alecelular/nanoosciloscopio/Fotos/Arduino_NANO_128x32/IMG_20260410_170420.jpg

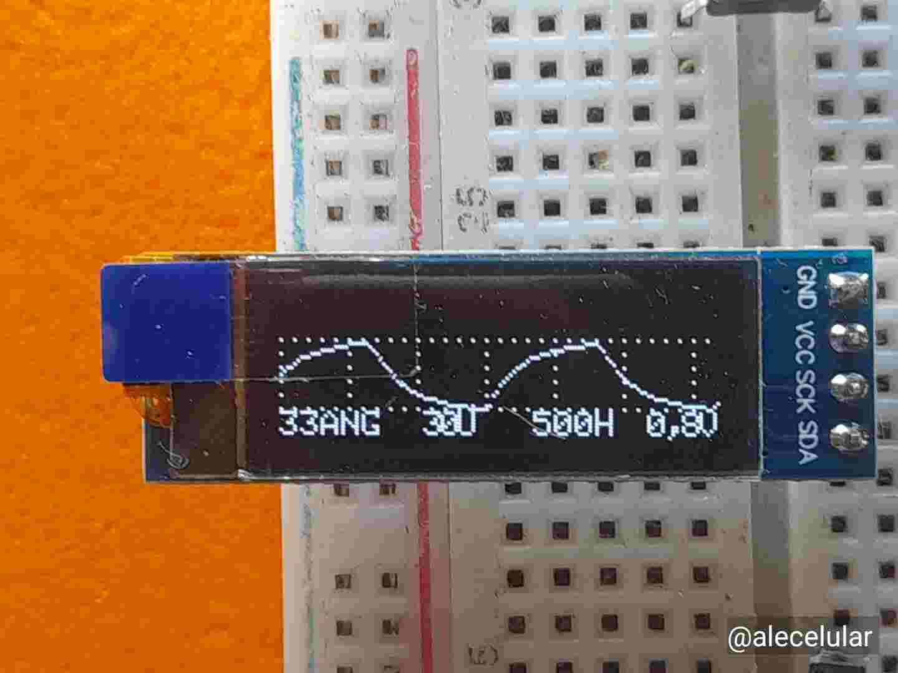
Fotos/Arduino_NANO_128x32/IMG_20260410_170420.jpg
