alecelular/nanoosciloscopio/Fotos/Arduino_PRO_Mini/IMG_20260922_135904.jpg

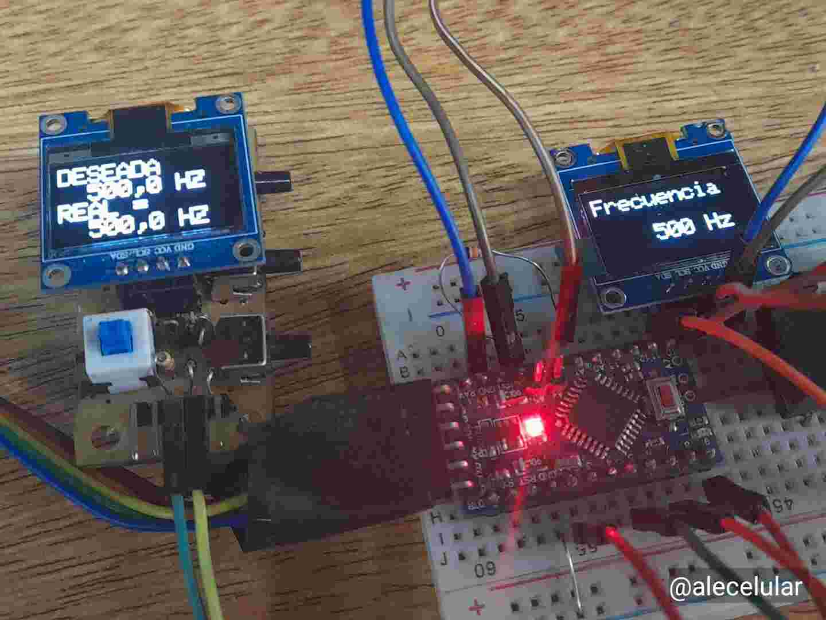
Fotos/Arduino_PRO_Mini/IMG_20260922_135904.jpg
