alecelular/nanoosciloscopio/Fotos/Arduino_PRO_Mini/IMG_20260922_142356.jpg

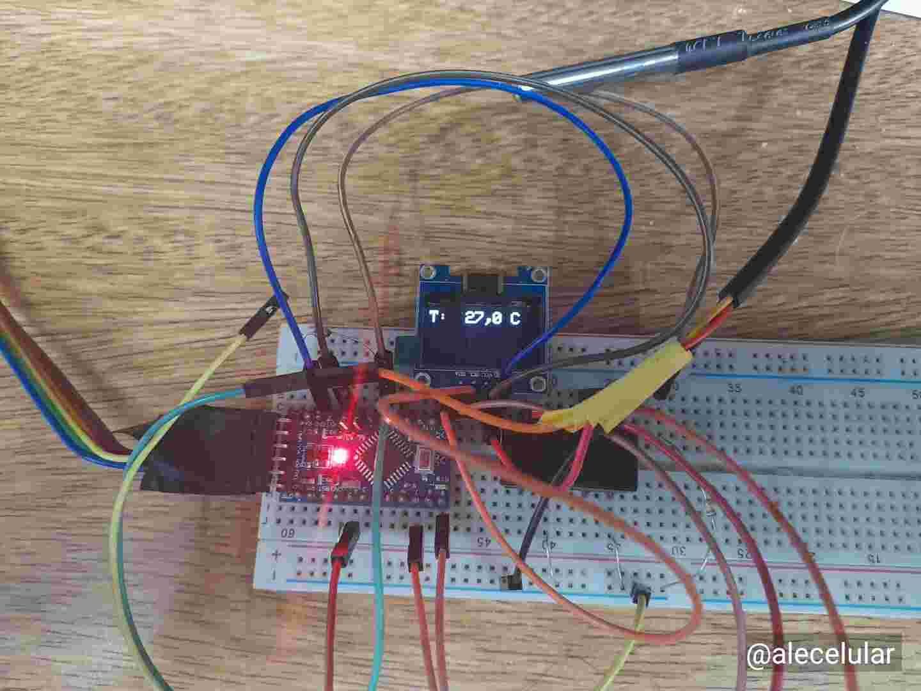
Fotos/Arduino_PRO_Mini/IMG_20260922_142356.jpg
