alecelular/nanoosciloscopio/Fotos/Arduino_PRO_Mini/IMG_20260926_133228.jpg

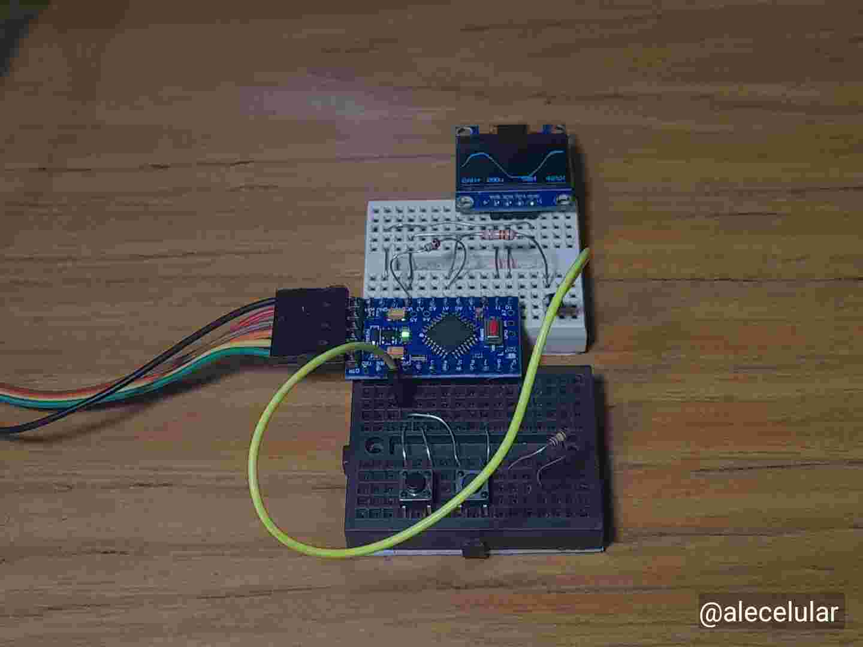
Fotos/Arduino_PRO_Mini/IMG_20260926_133228.jpg
