alecelular/nanoosciloscopio/Fotos/Arduino_PRO_Mini/IMG_20260927_163220.jpg

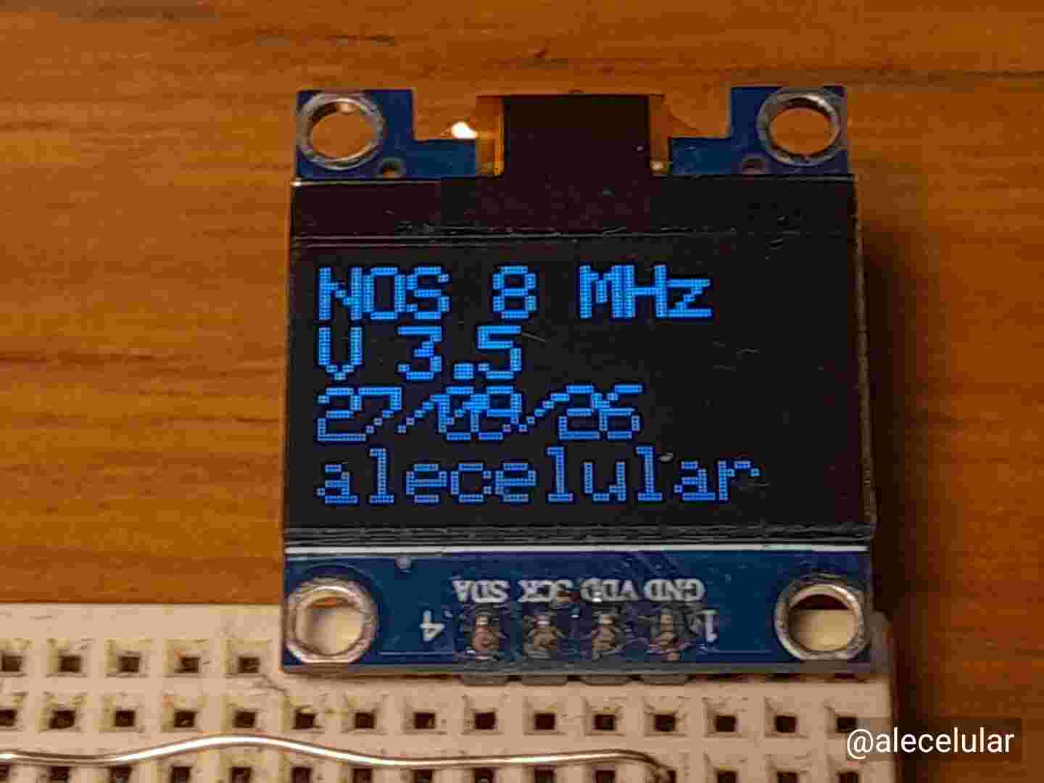
Fotos/Arduino_PRO_Mini/IMG_20260927_163220.jpg
