alecelular/nanoosciloscopio/Fotos/Arduino_PRO_Mini/IMG_20260927_163222.jpg

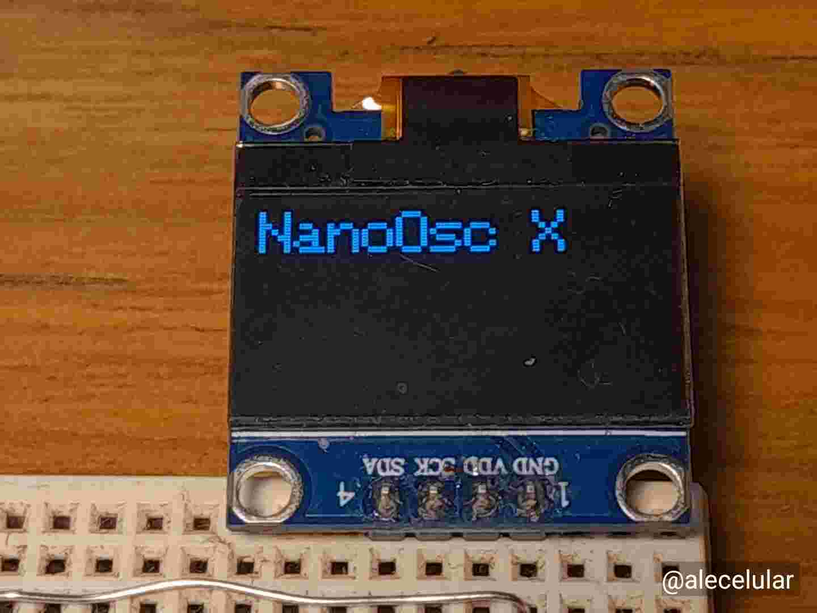
Fotos/Arduino_PRO_Mini/IMG_20260927_163222.jpg
