alecelular/nanoosciloscopio/Fotos/ATtiny85/IMG_20260514_092656.jpg

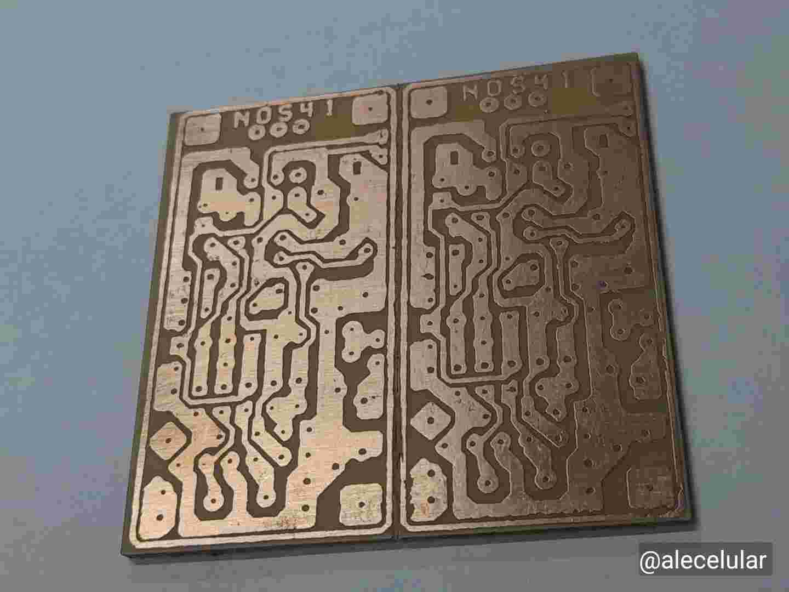
Fotos/ATtiny85/IMG_20260514_092656.jpg
