alecelular/nanoosciloscopio/Fotos/ATtiny85/IMG_20260514_103825.jpg

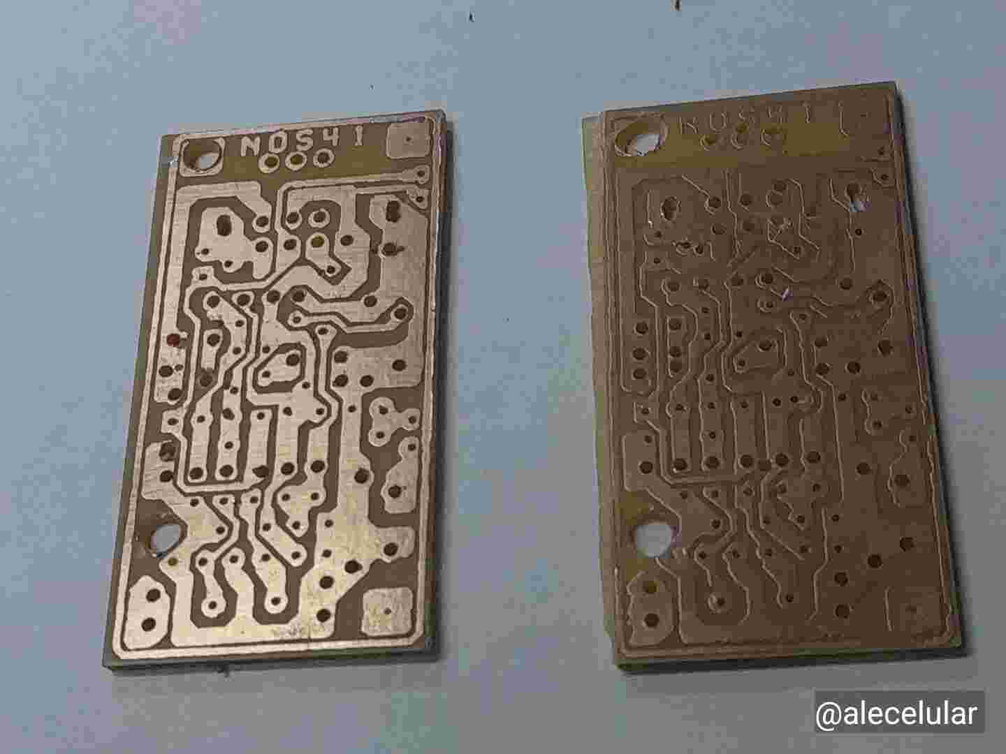
Fotos/ATtiny85/IMG_20260514_103825.jpg
