alecelular/nanoosciloscopio/Fotos/ATtiny85/IMG_20260515_105952.jpg

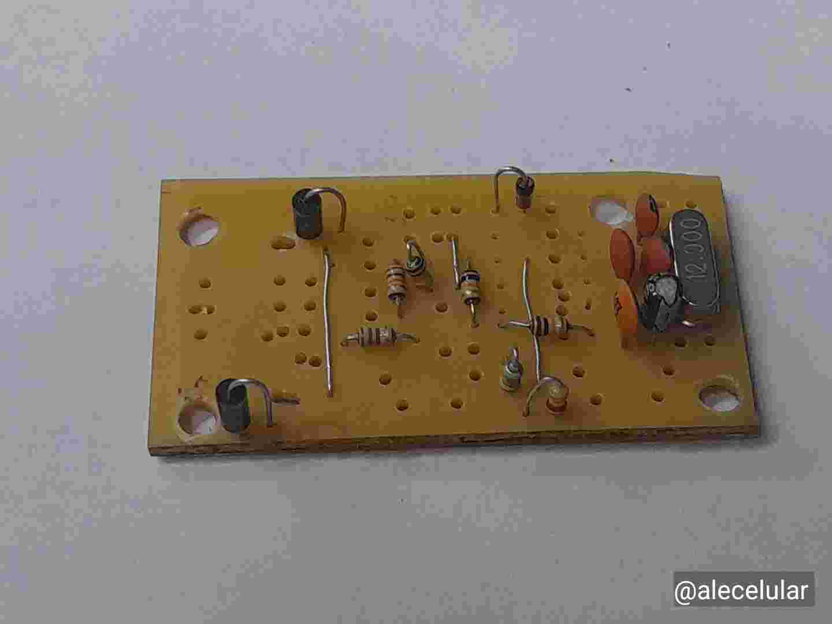
Fotos/ATtiny85/IMG_20260515_105952.jpg
