alecelular/nanoosciloscopio/Fotos/ATtiny85/IMG_20260515_112648.jpg

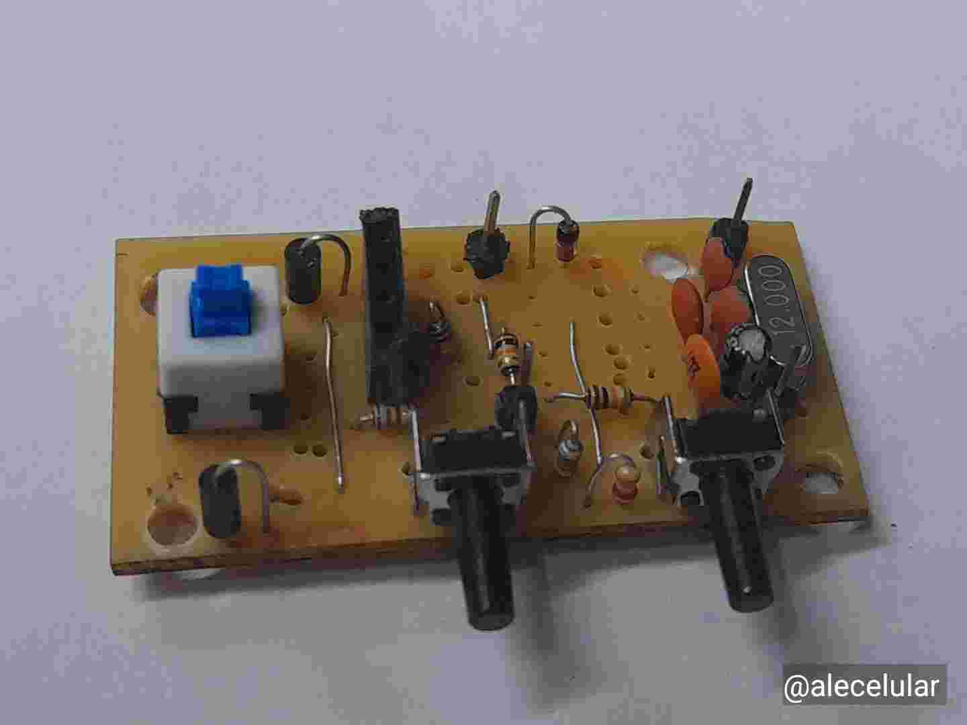
Fotos/ATtiny85/IMG_20260515_112648.jpg
