alecelular/nanoosciloscopio/Fotos/ATtiny85/IMG_20260515_112658.jpg

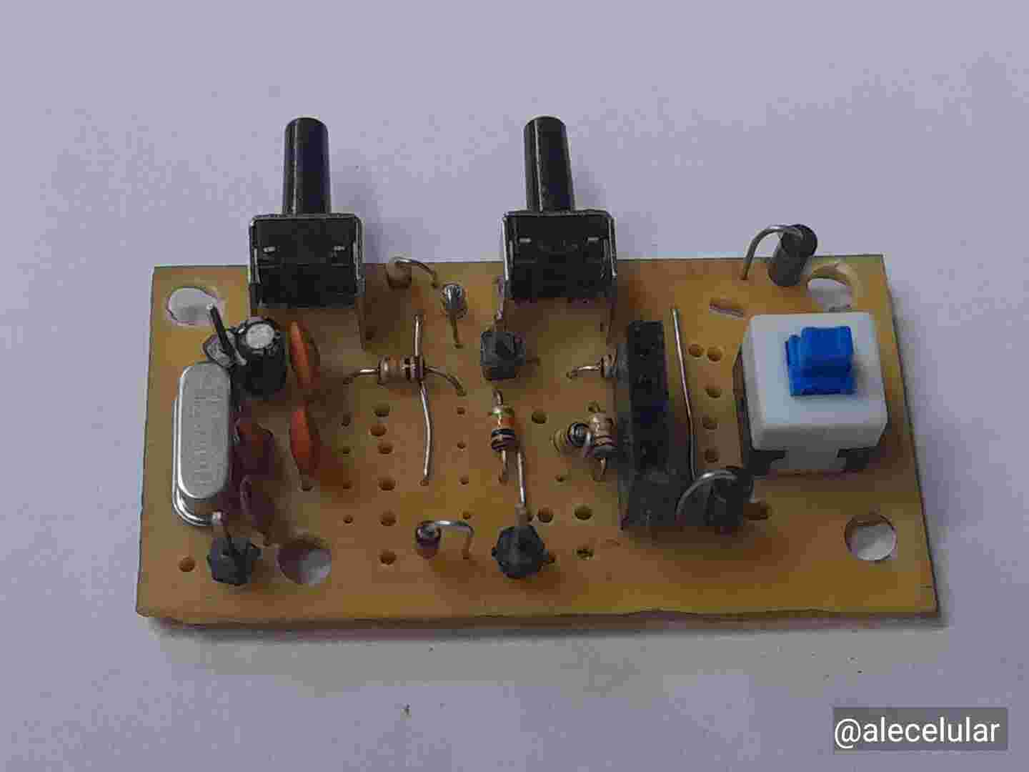
Fotos/ATtiny85/IMG_20260515_112658.jpg
