alecelular/nanoosciloscopio/Fotos/ATtiny85/IMG_20260515_113447.jpg

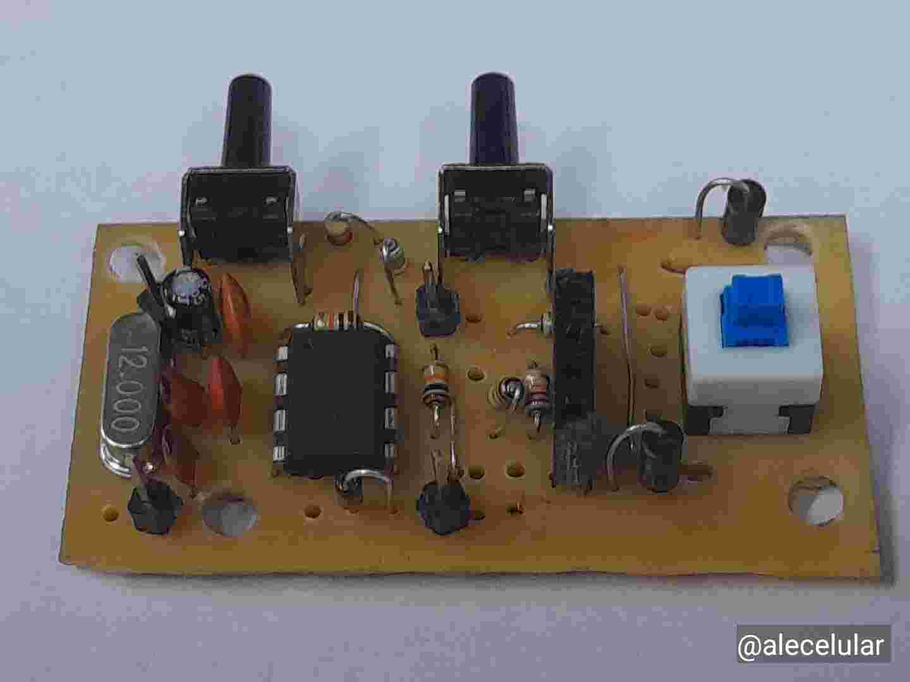
Fotos/ATtiny85/IMG_20260515_113447.jpg
