alecelular/nanoosciloscopio/Fotos/ATtiny85/IMG_20260515_121459.jpg

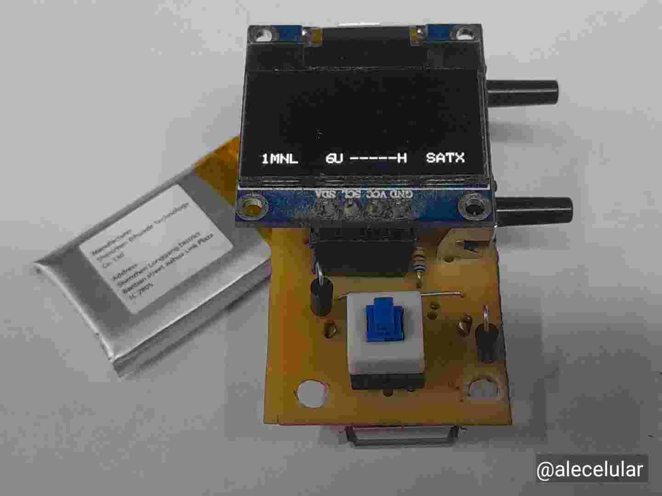
Fotos/ATtiny85/IMG_20260515_121459.jpg
