alecelular/nanoosciloscopio/Fotos/ATtiny85/IMG_20260515_121541.jpg

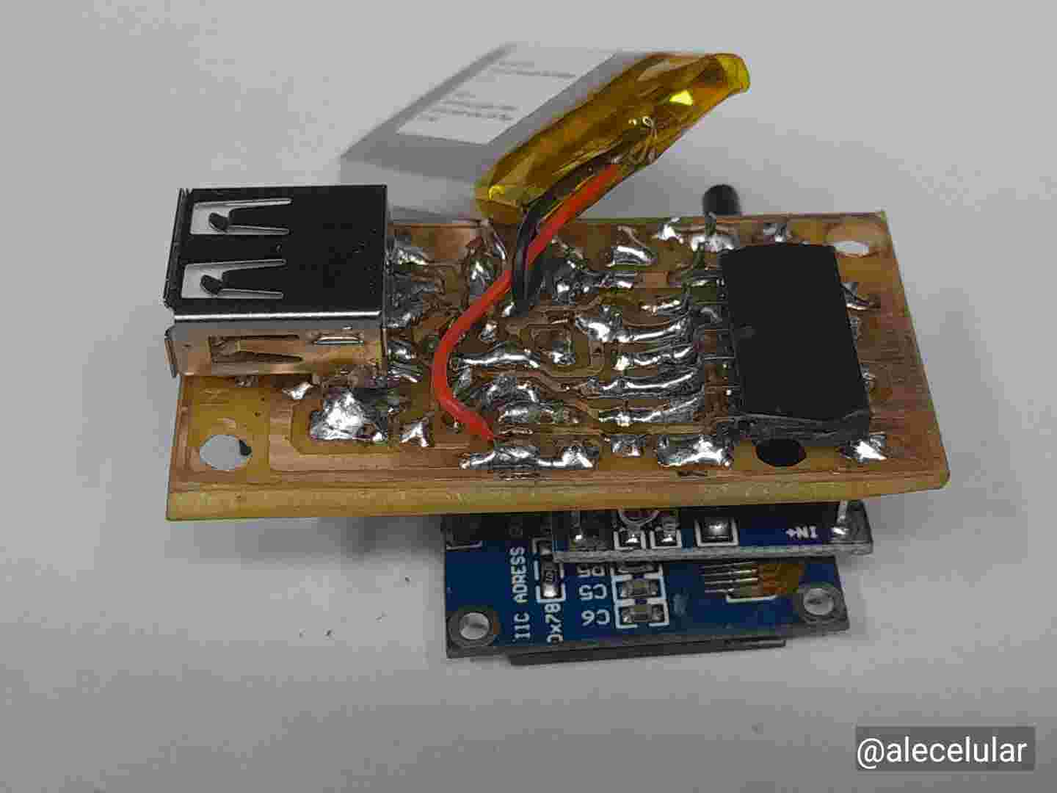
Fotos/ATtiny85/IMG_20260515_121541.jpg
