alecelular/nanoosciloscopio/Fotos/ATtiny85/IMG_20260515_134651.jpg

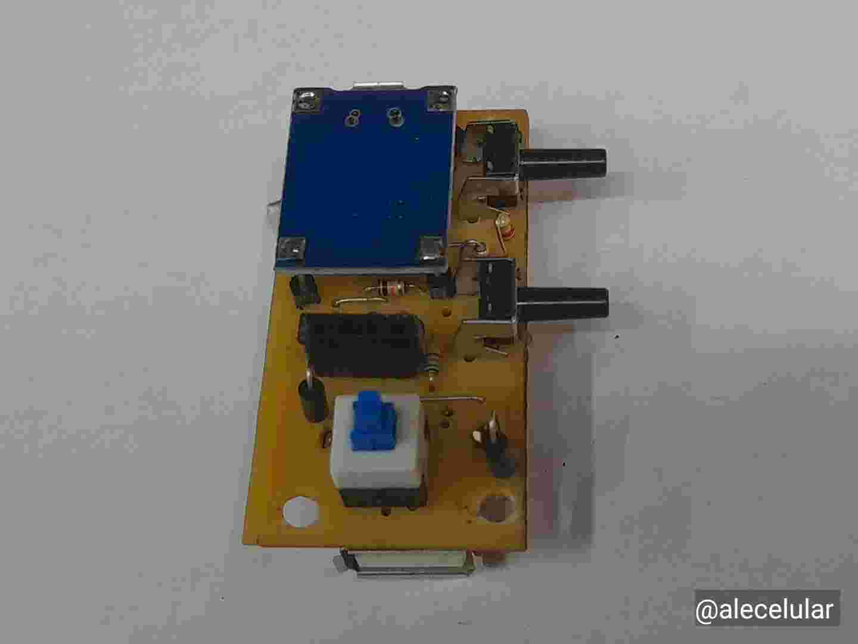
Fotos/ATtiny85/IMG_20260515_134651.jpg
