alecelular/nanoosciloscopio/Fotos/ATtiny85/IMG_20260527_100653.jpg

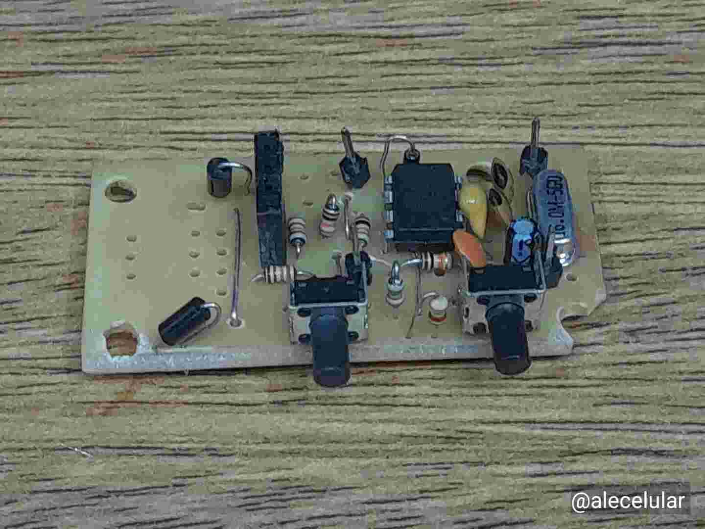
Fotos/ATtiny85/IMG_20260527_100653.jpg
