alecelular/nanoosciloscopio/Fotos/ATtiny85/IMG_20260527_103941.jpg

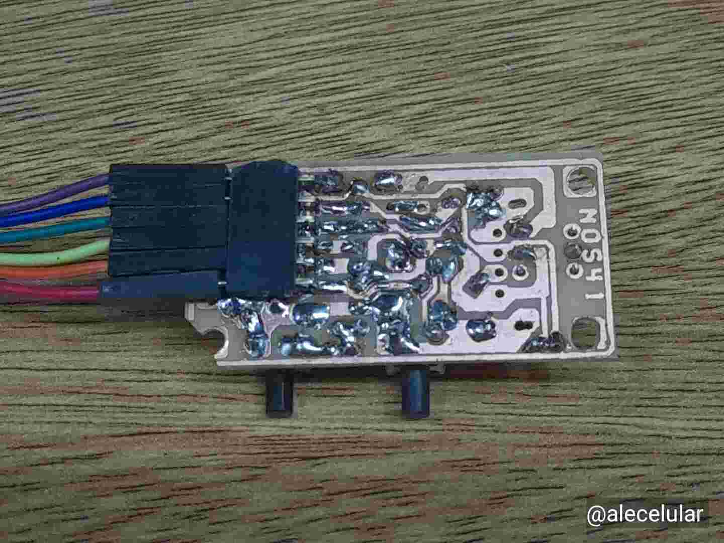
Fotos/ATtiny85/IMG_20260527_103941.jpg
