alecelular/nanoosciloscopio/Fotos/ATtiny85/IMG_20260527_104001.jpg

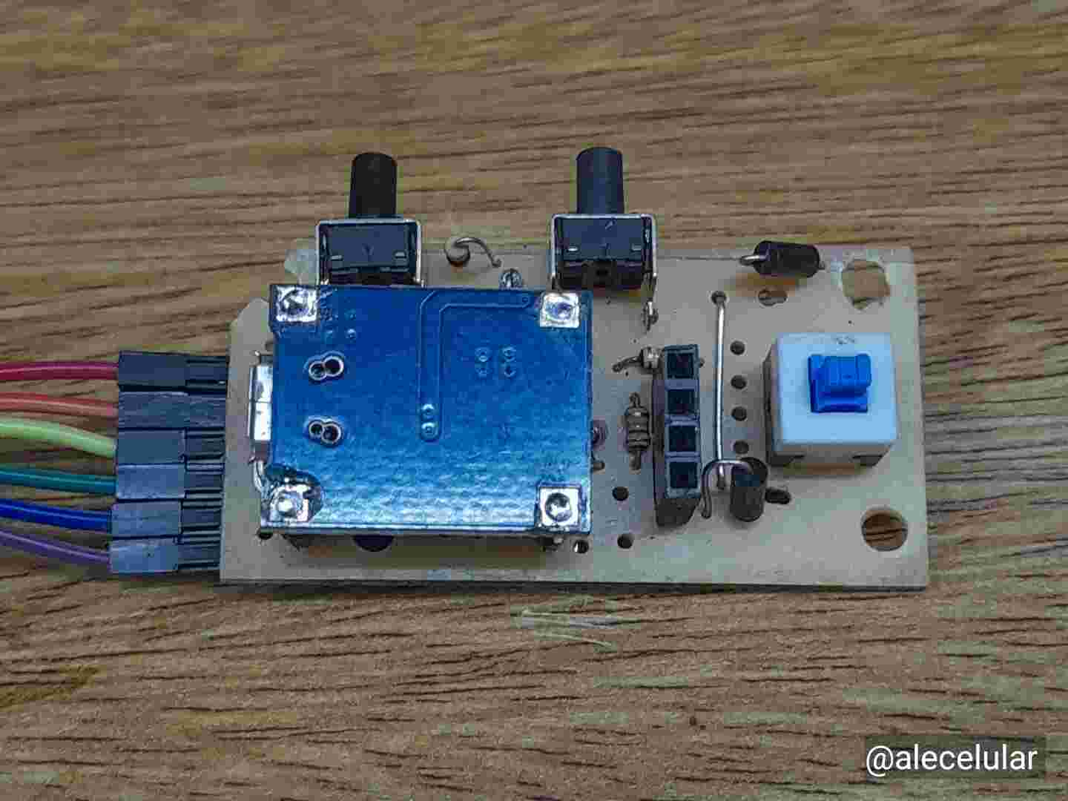
Fotos/ATtiny85/IMG_20260527_104001.jpg
