alecelular/nanoosciloscopio/Fotos/ATtiny85/IMG_20260527_104021.jpg

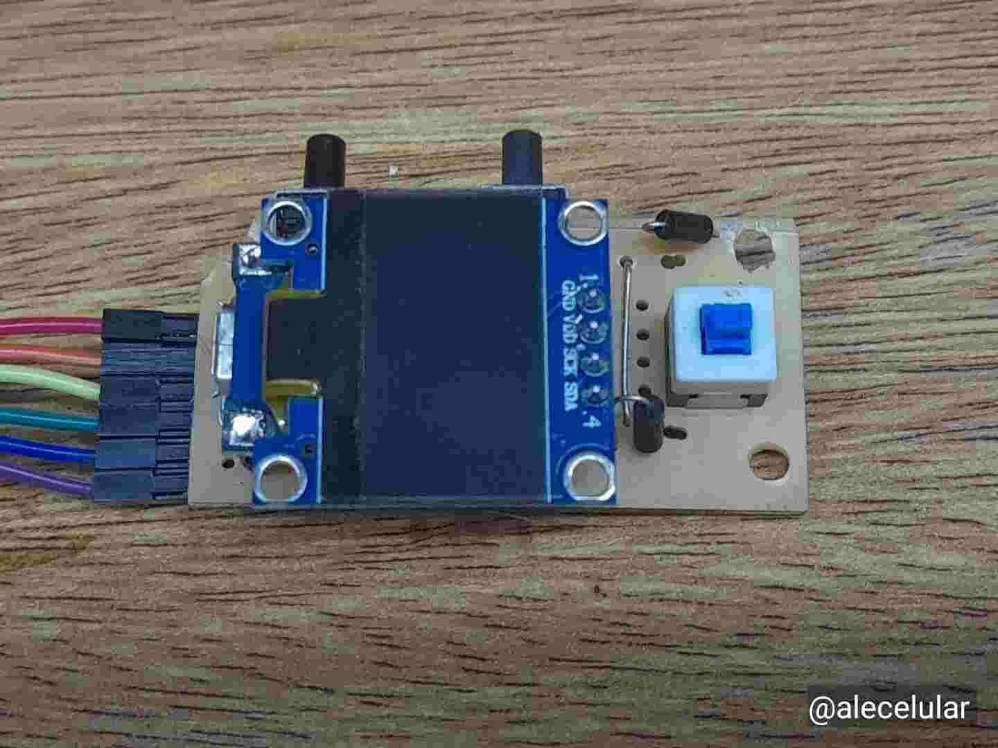
Fotos/ATtiny85/IMG_20260527_104021.jpg
