alecelular/nanoosciloscopio/Fotos/ATtiny85/IMG_20260527_130948.jpg

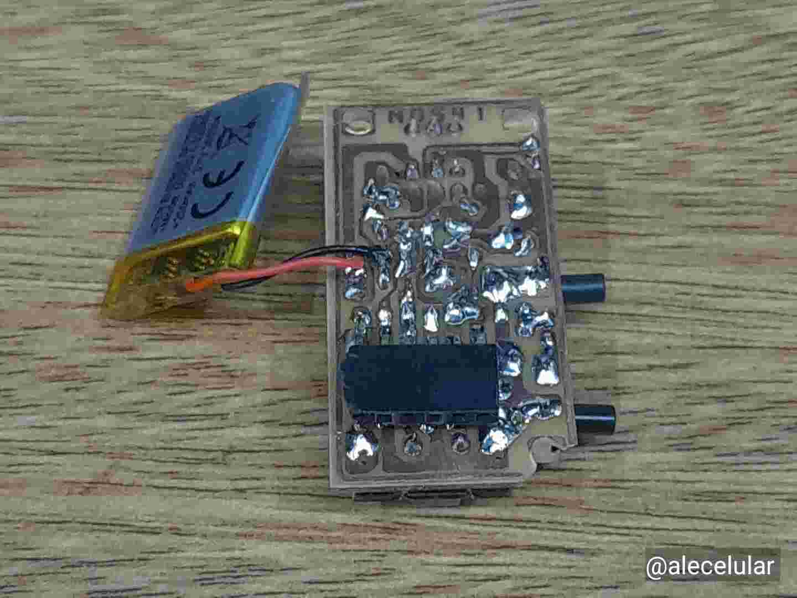
Fotos/ATtiny85/IMG_20260527_130948.jpg
