alecelular/nanoosciloscopio/Fotos/ATtiny85/IMG_20260527_131004.jpg

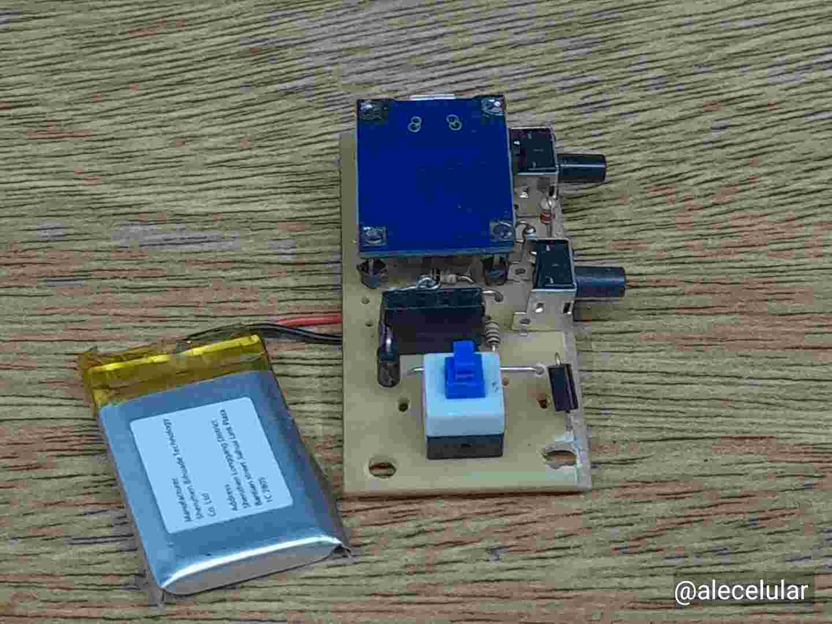
Fotos/ATtiny85/IMG_20260527_131004.jpg
