alecelular/nanoosciloscopio/Fotos/ATtiny85/IMG_20260527_131022.jpg

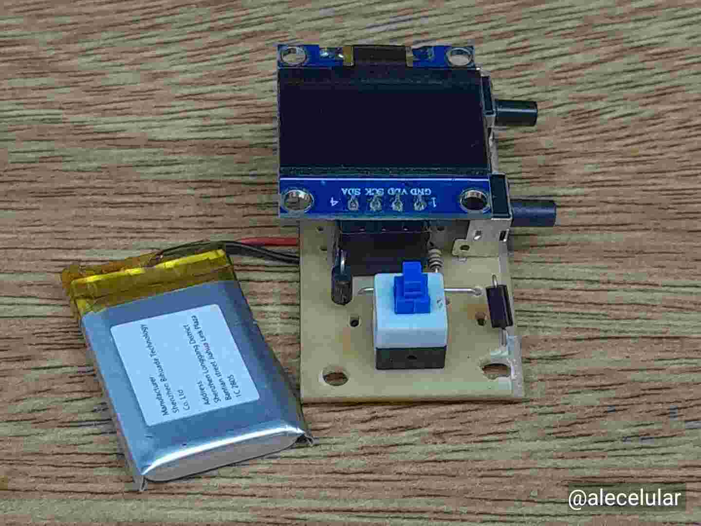
Fotos/ATtiny85/IMG_20260527_131022.jpg
