alecelular/nanoosciloscopio/Fotos/ATtiny85/IMG_20260527_200803.jpg

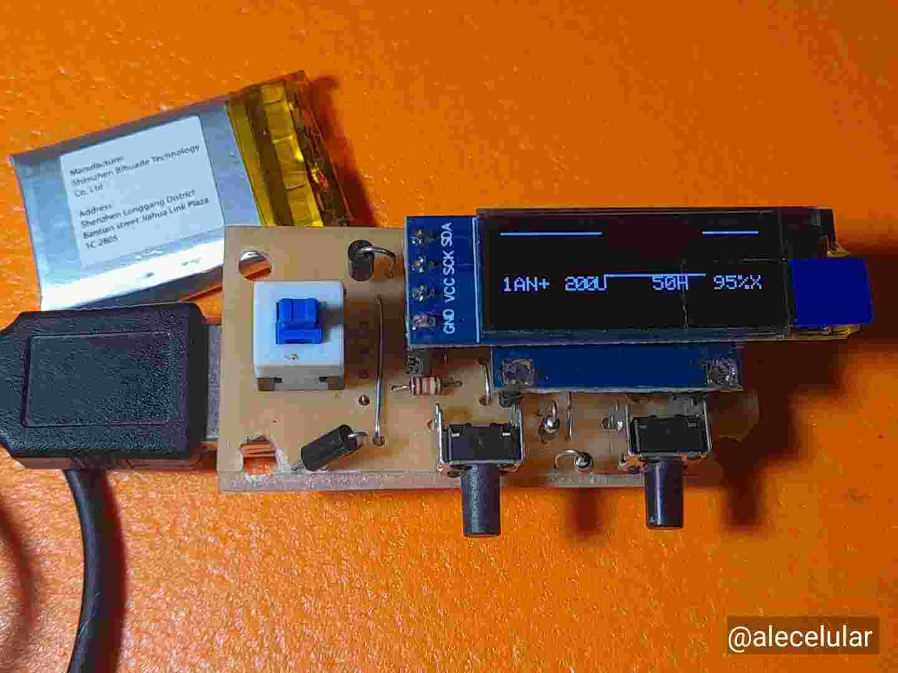
Fotos/ATtiny85/IMG_20260527_200803.jpg
