alecelular/nanoosciloscopio/Fotos/ATtiny85/IMG_20260529_213239.jpg

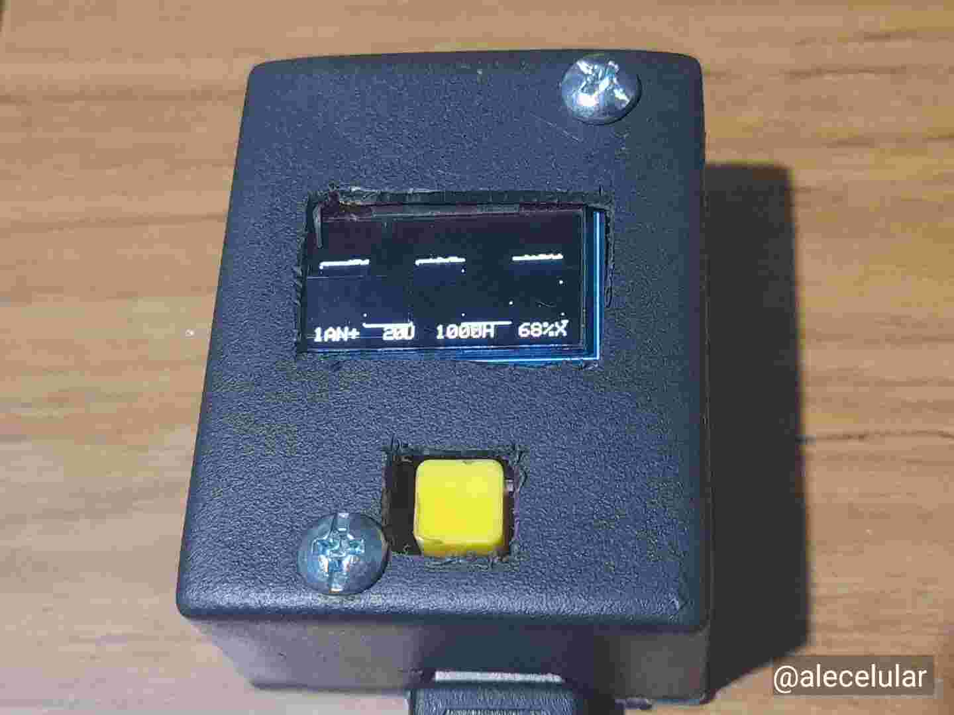
Fotos/ATtiny85/IMG_20260529_213239.jpg
