alecelular/nanoosciloscopio/Fotos/ATtiny85/IMG_20260529_213449.jpg

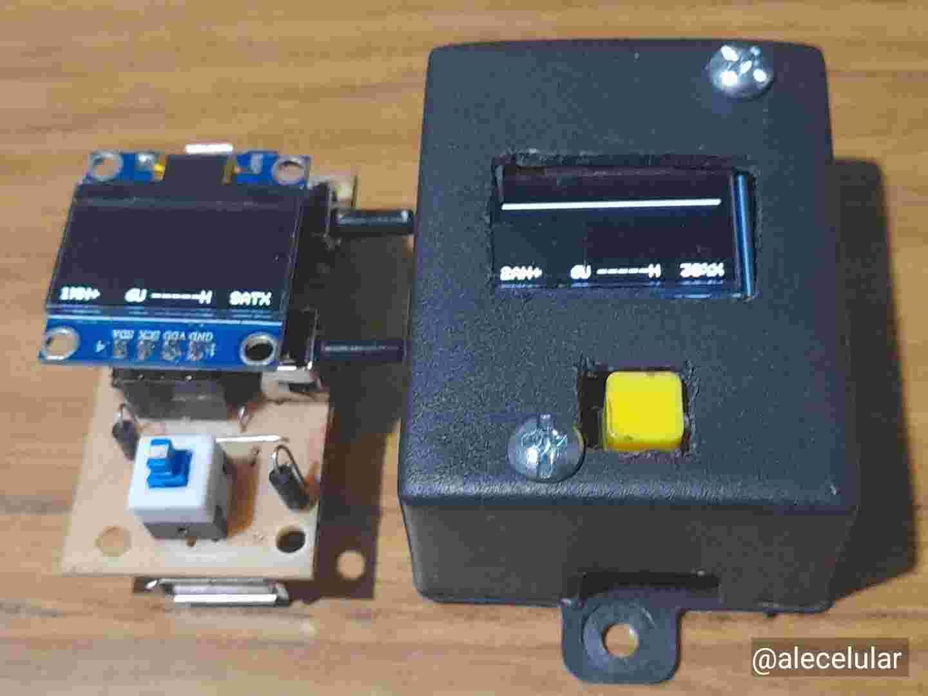
Fotos/ATtiny85/IMG_20260529_213449.jpg
