alecelular/nanoosciloscopio/Fotos/ATtiny85/IMG_20260529_214704.jpg

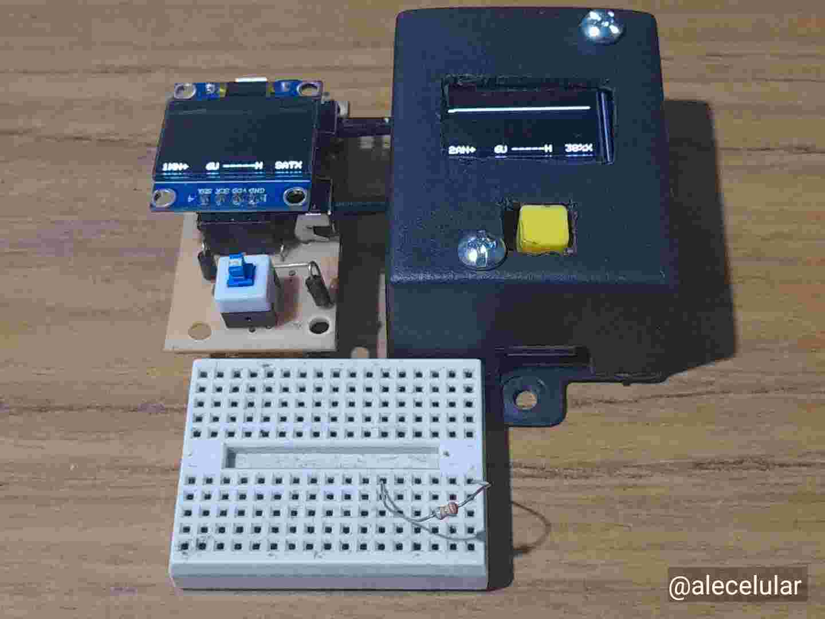
Fotos/ATtiny85/IMG_20260529_214704.jpg
