alecelular/nanoosciloscopio/Fotos/ATtiny85/IMG_20260531_150019.jpg

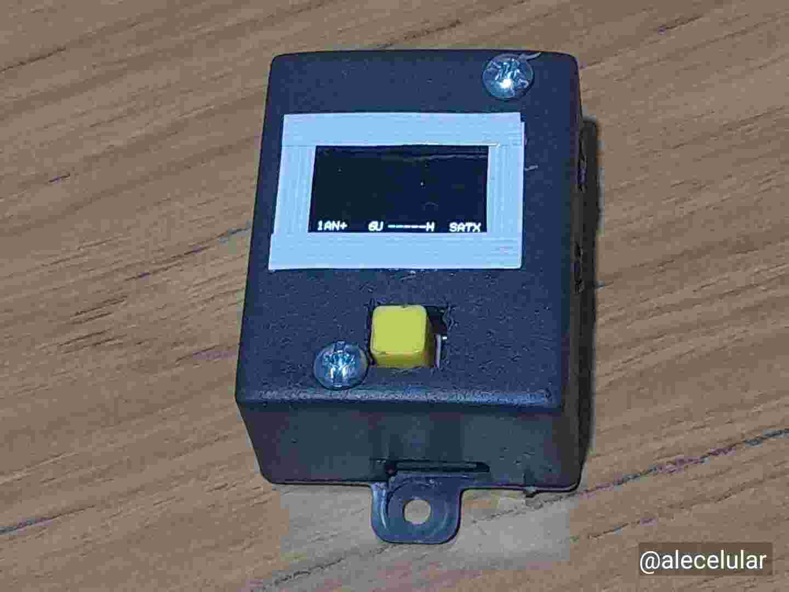
Fotos/ATtiny85/IMG_20260531_150019.jpg
