alecelular/nanoosciloscopio/Fotos/ATtiny85/IMG_20260531_150149.jpg

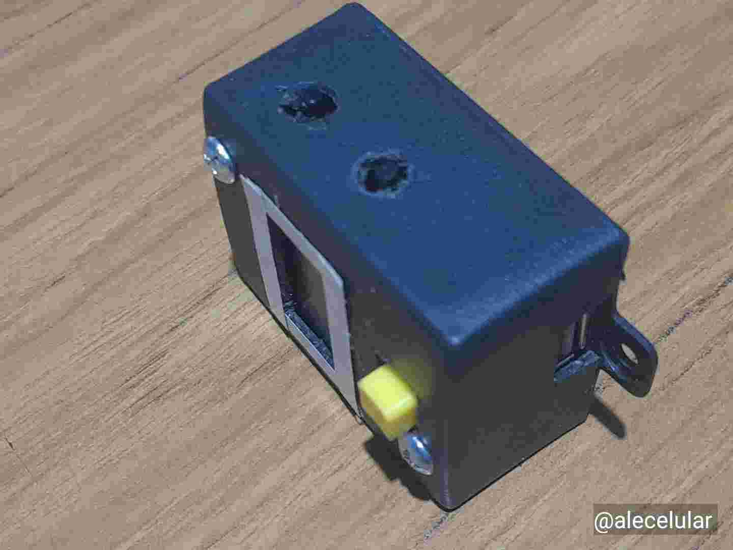
Fotos/ATtiny85/IMG_20260531_150149.jpg
