alecelular/nanoosciloscopio/Fotos/ATtiny85/IMG_20260925_102838.jpg

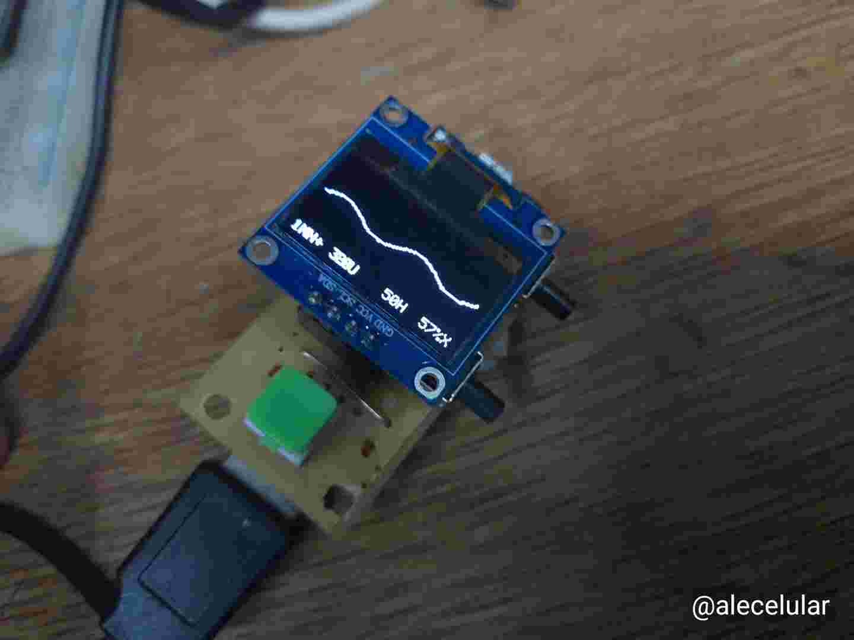
Fotos/ATtiny85/IMG_20260925_102838.jpg
