alecelular/nanoosciloscopio/Fotos/ATtiny85/IMG_20260926_124219.jpg

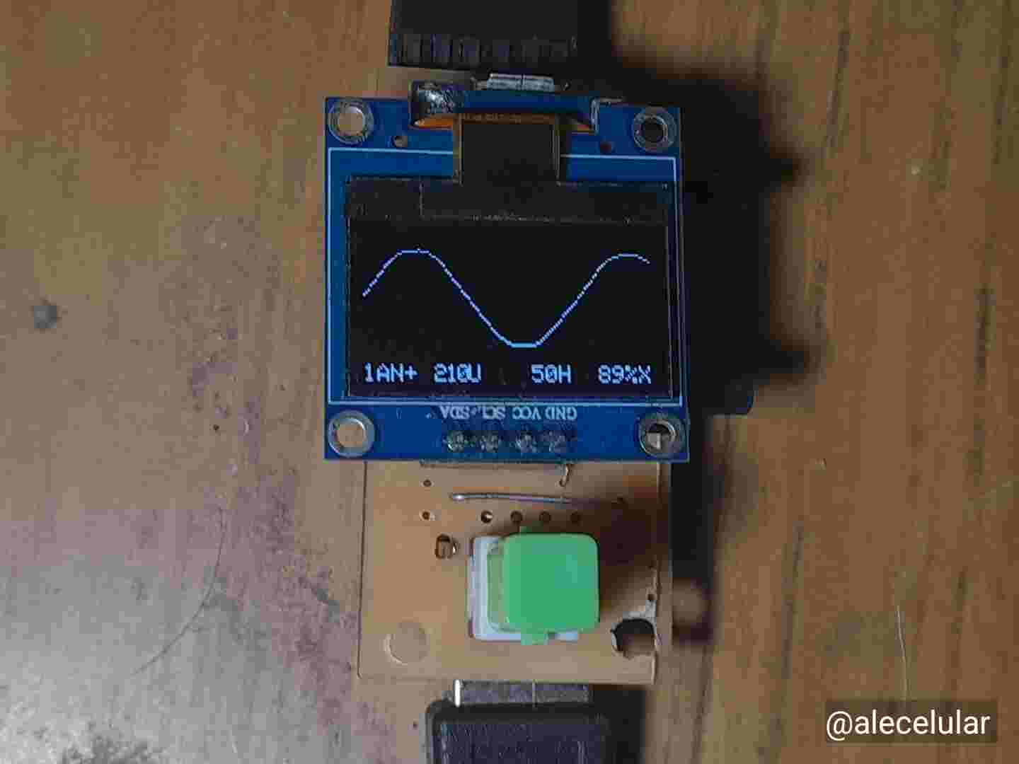
Fotos/ATtiny85/IMG_20260926_124219.jpg
