alecelular/nanoosciloscopio/Fotos/ATtiny85/IMG_20260926_124301.jpg

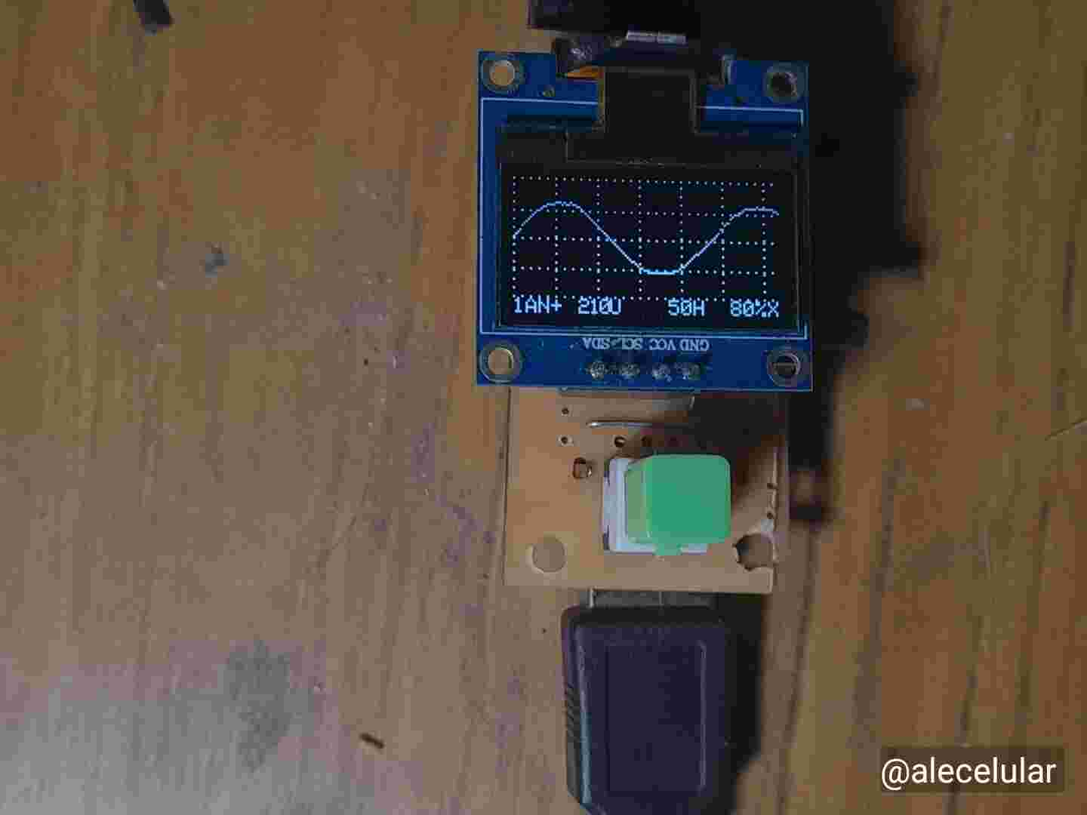
Fotos/ATtiny85/IMG_20260926_124301.jpg
