alecelular/nanoosciloscopio/hardware/Esquema_Nano-Osciloscopio_ATmega328P.pdf

## Se muestran patas de Arduino nano, adaptable a los otros

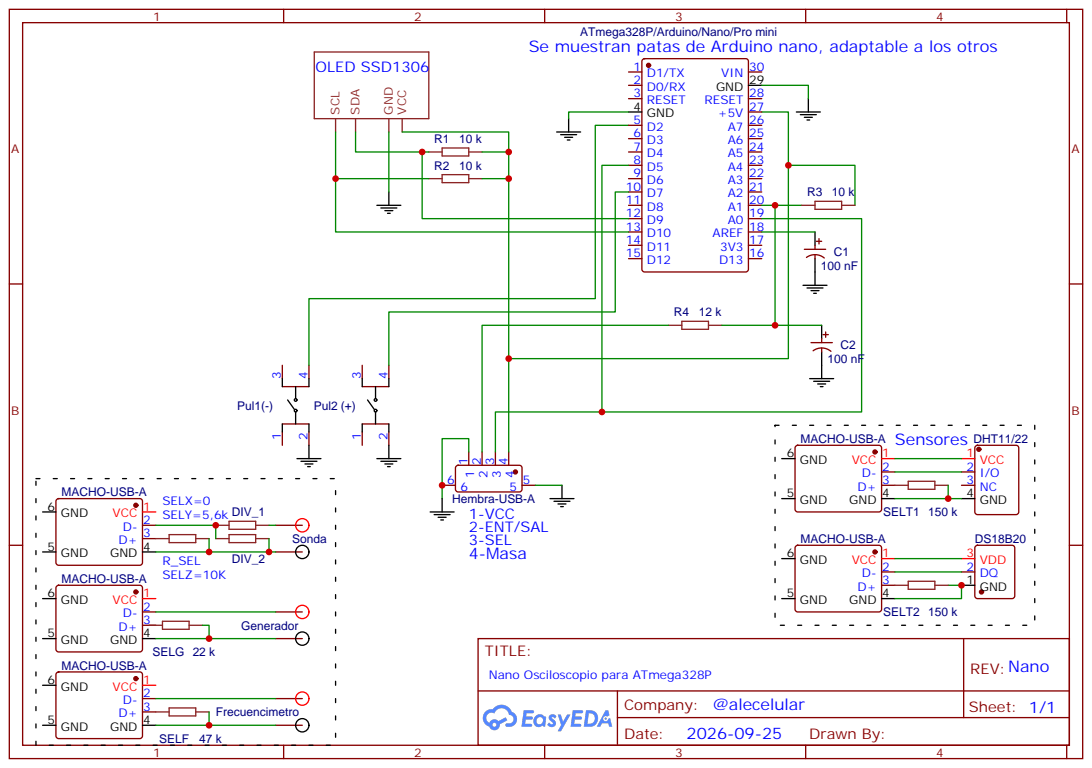
[picture p39: page 1]

ATmega328P/Arduino/Nano/Pro mini
