alecelular/nanoosciloscopio/hardware/Esquema_Nano-Osciloscopio_ATtiny85.pdf

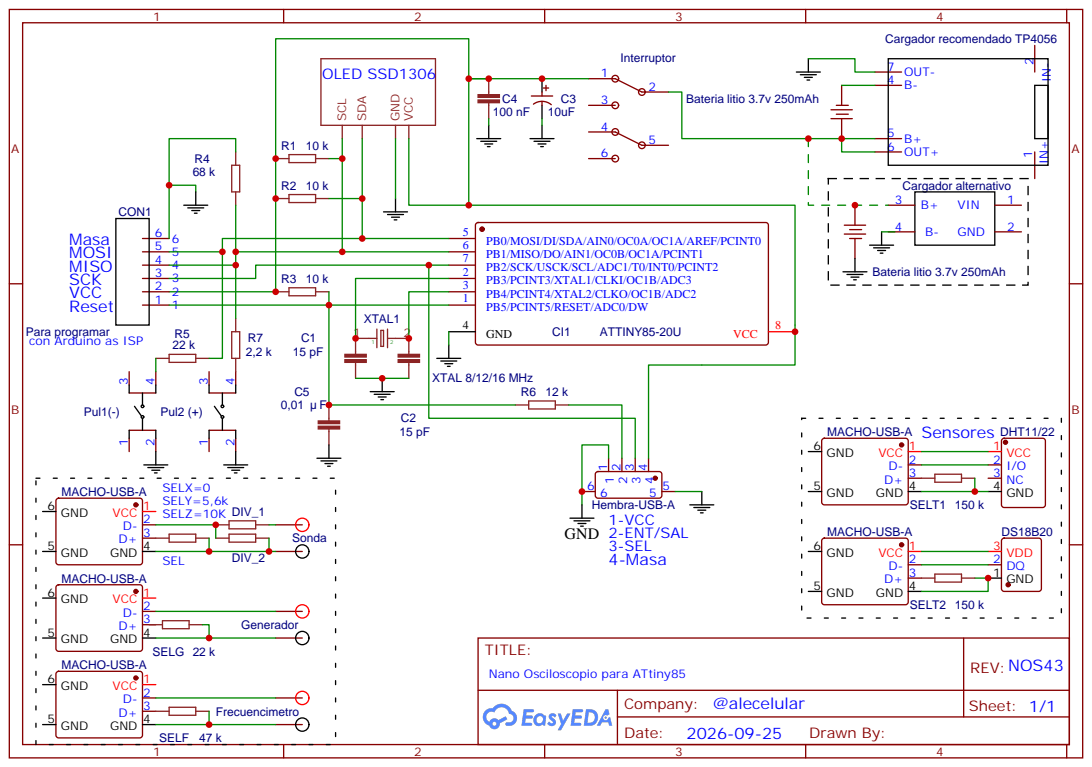
[picture p40: page 1]
