alecelular/nanoosciloscopio/src/I2C.ino

/*
 Nanoosciloscopio

 Alejandro F. Fernández  
 nanoosciloscopio@gmail.com
 Año: 2026

 Descripción:
 Osciloscopio simple usando ADC y temporización por
 interrupciones.

 CPU:
 - ATtiny85, eventualmente ATmega328P

 Licencia: Uso no comercial
 Ver archivo LICENSE para más detalles

 Notas:
 - Optimizado para bajo consumo de memoria
 - Uso intensivo de interrupciones
*/

// Controlador mínimo para hacer I2C a mano (bitBang)
// para poder usar la pantalla. En teoría puede usarse
// para otros dispositivos, siempre que pueda entrar en
// el código, pero no lo recomiendo. En caso de un ATmega328P,
// esto no choca con el I2C nativo y se puede usar independien-
// temente de esta implementación.

// Sección I2C para conectar la pantalla SSD1306/SH1106

#if defined(__AVR_ATtiny85__)

 // En ATtiny85 SDA es PB0 pata 5 y SCL es PB1 pata 6
 #define SDA PB0
 #define SCL PB1
 #define PORT_I2C PORTB
 #define DDR_I2C  DDRB
 #define PIN_I2C  PINB

#else

 // Para Arduino UNO, Nano o Pro Mini
 // (Usando PB1 y PB2, o alternativa PB2 y PB3)
 //#define SDA 3          // Alternativas posibles
 //#define SCL 2
 #define SDA 1
 #define SCL 2
 #define PORT_I2C PORTB
 #define DDR_I2C  DDRB
 #define PIN_I2C  PINB

#endif

// 1 es 1 µs, 4 son 4 µs. 0 = No tiene retardo
#if defined(__AVR_ATmega328P__)
#define RetardoI2C 1
#else
#define RetardoI2C 0
#endif

#if RetardoI2C!=0
#define SDA_ALTO() PORT_I2C|=(1<<SDA);  __builtin_avr_delay_cycles((RetardoI2C*F_CPU)/1000000UL)
#define SDA_BAJO() PORT_I2C&=~(1<<SDA); __builtin_avr_delay_cycles((RetardoI2C*F_CPU)/1000000UL)
#define SCL_ALTO() PORT_I2C|=(1<<SCL);  __builtin_avr_delay_cycles((RetardoI2C*F_CPU)/1000000UL)
#define SCL_BAJO() PORT_I2C&=~(1<<SCL); __builtin_avr_delay_cycles((RetardoI2C*F_CPU)/1000000UL)
#else
#define SDA_ALTO() PORT_I2C|=(1<<SDA)
#define SDA_BAJO() PORT_I2C&=~(1<<SDA)
#define SCL_ALTO() PORT_I2C|=(1<<SCL)
#define SCL_BAJO() PORT_I2C&=~(1<<SCL)
#endif

void i2c_inicio()
{
 DDR_I2C|=(1<<SDA) | (1<<SCL);
 SDA_ALTO();
 SCL_ALTO();
}

void i2c_comienzo()
{
 SDA_ALTO();
 SCL_ALTO();
 SDA_BAJO();
 SCL_BAJO();
}

// De paso limpia el bus
void i2c_parar()
{
 SDA_BAJO();
 SCL_ALTO();
 SDA_ALTO();
}

byte i2c_escribir(byte b)
{
 for(byte i=0;i<8;i++)
 {
  if(b & 0x80)
  {
   SDA_ALTO();
  }
  else
  {
   SDA_BAJO();
  }
  SCL_ALTO();  // Pulso alto
  SCL_BAJO();  // Pulso bajo
  b<<=1;
 }

 // LECTURA DEL ACK
 // SDA como entrada para escuchar al esclavo
 DDR_I2C&=~(1<<SDA);
 SCL_ALTO();
    
 // Leo el registro PIN_I2C (0 = ACK, 1 = NACK)
 byte ack=(PIN_I2C & (1<<SDA))?1:0;
 SCL_BAJO();
 DDR_I2C|=(1<<SDA); // SDA vuelve a ser salida
 SDA_ALTO();        // Libero SDA
 return ack; 
}

// Sección Pantalla OLED

// Para optimizar FLASH:
// FUENTE_MAX==0xFF Todos
// FUENTE_MAX==0x7F Hasta 127
// FUENTE_MAX==0x5F Hasta '_'
// FUENTE_MAX==0x5A Hasta 'Z'
#if defined(__AVR_ATmega328P__)
#define FUENTE_MAX 0xFF
#else
#define FUENTE_MAX 0x5A
#endif

#define PANTALLA_ADDR 0x3C

byte cursorX=0;
byte cursorY=0;
byte tipografia=0;
byte espaciado=1;

extern const byte Tipografia5x7[] PROGMEM;

void pantalla_cmd(byte c)
{
 i2c_parar();         // Esencial para cerrar aperturas previas
 i2c_comienzo();
 i2c_escribir(PANTALLA_ADDR<<1);
 i2c_escribir(0x00);
 i2c_escribir(c);
 i2c_parar();
}

void pantalla_comienzoDatos()
{
 i2c_comienzo();
 i2c_escribir(PANTALLA_ADDR<<1);
 i2c_escribir(0x40);
}

void pantalla_posicionar(byte x, byte pag)
{
 // Si sospecho que el bus quedó abierto, i2c_parar() aquí
 // es un salvavidas
 i2c_parar(); 
 #if OLED<=4
 pantalla_cmd(0xB0 | (pag+4));
 #else
 pantalla_cmd(0xB0 | pag);
 #endif
 #ifdef SH1106
 // Desfase para centrar las 128 columnas físicas
 byte x_sh = x + 2; 
 pantalla_cmd(0x00 | (x_sh & 0x0F)); 
 pantalla_cmd(0x10 | (x_sh >> 4));   
 #else
 pantalla_cmd(0x00 | (x & 0x0F));
 pantalla_cmd(0x10 | (x >> 4));
 #endif
}

const byte iniOled[] PROGMEM={
 0xAE,          // Apagar pantalla
 0xD5, 0x50,    // Configurar oscilador
 0xA8, 0x3F,    // Multiplex ratio
 0xD3, 0x00,    // Desplazamiento a 0
 0x40,          // Línea de inicio RAM a 0
 
 // Comando de energía propio (Bomba de carga)
 #ifdef SH1106
 0xAD, 0x8B,    
 #else
 0x8D,0x14,
 #endif
 
 0x20, 0x00,    // Direccionamiento por páginas
 0xDA,

 #if OLED<=4
 0x02, 0xA1, 0xC8,
 #else
 0x12, 0xA0, 0xC0,
 #endif

 0x81, 0x7F,    // Contraste medio
 0xD9,

 #ifdef SH1106
 0x22,    // Pre-carga óptima para SH1106
 #else
 0xF1,
 #endif

 0xDB,

 #ifdef SH1106
 0x35,    // Nivel VCOMH
 #else
 0x40,
 #endif

 0xA4,          // Salida RAM normal
 0xA6,          // Pantalla normal
 0xAF           // Encender pantalla
};

void pantalla_comienzo()
{
 i2c_inicio();
 for(byte i=0;i<sizeof(iniOled);i++) pantalla_cmd(pgm_read_byte(&iniOled[i]));
}

void pantalla_encendida()
{
 pantalla_cmd(0xAF);
}

void pantalla_cursor(byte x, byte y)
{
 cursorX=x;
 cursorY=y;
 pantalla_posicionar(x,y);
}

void pantalla_limpia()
{
 i2c_inicio();                
 for(byte pag=0;pag<8;pag++)
 {
  i2c_parar(); 
  #if OLED<=4
  pantalla_cmd(0xB0 | (pag+4));
  #else
  pantalla_cmd(0xB0 | pag);
  #endif
  pantalla_cmd(0x00); // Forzar columna baja 0
  pantalla_cmd(0x10); // Forzar columna alta 0
  pantalla_comienzoDatos();

  // EN SH1106 son 132 y en SSD1306, 128
  #ifdef SH1106
  for(byte i=0;i<132;i++)
  #else
  for(byte i=0;i<128;i++)
  #endif
  {
   i2c_escribir(0x00);
  }
  i2c_parar();
 }
 #if OLED<8
 pantalla_modoTipo(1);
 #else
 pantalla_modoTipo(2);
 #endif
 pantalla_separacion(1);
 pantalla_cursor(0,0);
}

void pantalla_limpiaPagina(byte pag)
{
 pantalla_cmd(0xB0 | pag);
 pantalla_cmd(0x00); // Forzar columna baja 0
 pantalla_cmd(0x10); // Forzar columna alta 0
 pantalla_comienzoDatos();
 
 // EN SH1106 son 132 y en SSD1306, 128
 #ifdef SH1106
 for(byte i=0;i<132;i++)
 #else
 for(byte i=0;i<128;i++)
 #endif
 {
  i2c_escribir(0x00);
 }
 i2c_parar();
}

// Invierte toda la pantalla
void pantalla_invertir(byte inv)
{
 if(inv) pantalla_cmd(0xA7); else pantalla_cmd(0xA6);
}

void pantalla_modoTipo(byte m)
{
 tipografia=m;
}

void pantalla_separacion(byte s)
{
 espaciado=s;
}

const byte expand2[16] PROGMEM =
{
0x00,0x03,0x0C,0x0F,
0x30,0x33,0x3C,0x3F,
0xC0,0xC3,0xCC,0xCF,
0xF0,0xF3,0xFC,0xFF
};

void pantalla_car(char c)
{
 // FUENTE_MAX==0xFF Todos
 // FUENTE_MAX==0x7F Hasta 127
 // FUENTE_MAX==0x5F Hasta '_'
 // FUENTE_MAX==0x5A Hasta 'Z'

 #if FUENTE_MAX<=0x5F
 // Las minúsculas las paso a mayúsculas cuando hay poca flash
 if(c>='a' && c<='z') c-=0x20;
 #endif

 unsigned long int ind=(c-32)*5;

 if(tipografia==0)
 {
  for(byte i=0;i<5;i++)
  {
   byte col=pgm_read_byte(&Tipografia5x7[ind+i]);
   i2c_escribir(col);
  }
  for(byte i=0;i<espaciado;i++) i2c_escribir(0);
  cursorX+=5+espaciado;
 }
 else if(tipografia==1)
 {
  for(byte i=0;i<5;i++)
  {
   byte col=pgm_read_byte(&Tipografia5x7[ind+i]);
   i2c_escribir(col);
   i2c_escribir(col);
  }
  for(byte i=0;i<espaciado*2;i++) i2c_escribir(0);
  cursorX+=10+espaciado*2;
 }
 else   // Tipografía 2
 {
  byte arriba[16];
  byte abajo[16];
  byte k=0;
  for(byte i=0;i<5;i++)
  {
   byte col=pgm_read_byte(&Tipografia5x7[ind+i]);
   byte t=pgm_read_byte(&expand2[col&0x0F]);
   byte b=pgm_read_byte(&expand2[col>>4]);

   arriba[k]=t;
   arriba[k+1]=t;
   abajo[k]=b;
   abajo[k+1]=b;
   k+=2;
  }
  for(byte i=0;i<espaciado;i++)
  {
   arriba[k]=0;
   abajo[k]=0;
   k++;
  }
  pantalla_posicionar(cursorX,cursorY);
  pantalla_comienzoDatos();
  for(byte i=0;i<k;i++) i2c_escribir(arriba[i]);
  i2c_parar();
  pantalla_posicionar(cursorX,cursorY+1);
  pantalla_comienzoDatos();
  for(byte i=0;i<k;i++) i2c_escribir(abajo[i]);
  i2c_parar();
  cursorX += k;
 }
}

void pantalla_printNumeroBase(unsigned long int n)
{
 if(n>=10) pantalla_printNumeroBase(n/10);
 pantalla_print((char)('0'+(n%10)));
}

void pantalla_print(byte n)
{
 pantalla_printNumeroBase(n);
}

void pantalla_print(unsigned int n)
{
 pantalla_printNumeroBase(n);
}

void pantalla_print(unsigned long n)
{
 pantalla_printNumeroBase(n);
}

void pantalla_print(char c)
{
 pantalla_comienzoDatos();
 pantalla_car(c);
 i2c_parar();
}

void pantalla_linea()
{
 byte altura=(tipografia==2)?2:1;
 cursorY=cursorY+altura;
 cursorX=0;
 pantalla_posicionar(0,cursorY);
}

void pantalla_print(const char *s)
{
 pantalla_comienzoDatos();
 while(*s)
 {
  char c=*s++;
  if(c=='\n')
  {
   i2c_parar();
   pantalla_linea();
   pantalla_comienzoDatos();
   continue;
  }
  pantalla_car(c);
 }
 i2c_parar();
}

void pantalla_println(const char *s)
{
 pantalla_print(s);
 if(tipografia==2) cursorY+=2; else cursorY++;
 cursorX=0;
 pantalla_posicionar(cursorX,cursorY);
}

void pantalla_print(const __FlashStringHelper *algo)
{
 PGM_P p=(PGM_P)algo;
 pantalla_comienzoDatos();
 while(true)
 {
  char c=pgm_read_byte(p++);
  if(!c) break;
  if(c=='\n')
  {
   i2c_parar();
   pantalla_linea();
   pantalla_comienzoDatos();
   continue;
  }
  pantalla_car(c);
 }
 i2c_parar();
}

void pantalla_println(const __FlashStringHelper *s)
{
 pantalla_print(s);
 pantalla_linea();
}

void pantalla_println()
{
 pantalla_linea();
}

// Una tipografía de 5x7 puntos de página 437

const byte Tipografia5x7 [] PROGMEM = {
/*
  0x00, 0x00, 0x00, 0x00, 0x00, //    \x00
  0x3E, 0x5B, 0x4F, 0x5B, 0x3E, // ☺  \x01
  0x3E, 0x6B, 0x4F, 0x6B, 0x3E, // ☻  \x02
  0x1C, 0x3E, 0x7C, 0x3E, 0x1C, // ♥  \x03
  0x18, 0x3C, 0x7E, 0x3C, 0x18, // ♦  \x04
  0x1C, 0x57, 0x7D, 0x57, 0x1C, // ♣  \x05
  0x1C, 0x5E, 0x7F, 0x5E, 0x1C, // ♠  \x06
  0x00, 0x18, 0x3C, 0x18, 0x00, // •  \x07
  0xFF, 0xE7, 0xC3, 0xE7, 0xFF, // ◘  \x08
  0x00, 0x18, 0x24, 0x18, 0x00, // ○  \x09
  0xFF, 0xE7, 0xDB, 0xE7, 0xFF, // ◙  \x0a
  0x30, 0x48, 0x3A, 0x06, 0x0E, // ♂  \x0b
  0x26, 0x29, 0x79, 0x29, 0x26, // ♀  \x0c
  0x40, 0x7F, 0x05, 0x05, 0x07, // ♪  \x0d
  0x40, 0x7F, 0x05, 0x25, 0x3F, // ♫  \x0e
  0x5A, 0x3C, 0xE7, 0x3C, 0x5A, // ☼  \x0f
  0x7F, 0x3E, 0x1C, 0x1C, 0x08, // ►  \x10
  0x08, 0x1C, 0x1C, 0x3E, 0x7F, // ◀  \x11
  0x14, 0x22, 0x7F, 0x22, 0x14, // ↕  \x12
  0x5F, 0x5F, 0x00, 0x5F, 0x5F, // ‼  \x13
  0x06, 0x09, 0x7F, 0x01, 0x7F, // ¶  \x14
  0x00, 0x66, 0x89, 0x95, 0x6A, // §  \x15
  0x60, 0x60, 0x60, 0x60, 0x60, // ▬  \x16
  0x94, 0xA2, 0xFF, 0xA2, 0x94, // ↨  \x17
  0x08, 0x04, 0x7E, 0x04, 0x08, // ↑  \x18
  0x10, 0x20, 0x7E, 0x20, 0x10, // ↓  \x19
  0x08, 0x08, 0x2A, 0x1C, 0x08, // →  \x1a
  0x08, 0x1C, 0x2A, 0x08, 0x08, // ←  \x1b
  0x1E, 0x10, 0x10, 0x10, 0x10, // ∟  \x1c
  0x0C, 0x1E, 0x0C, 0x1E, 0x0C, // ↔  \x1d
  0x30, 0x38, 0x3E, 0x38, 0x30, // ▲  \x1e
  0x06, 0x0E, 0x3E, 0x0E, 0x06, // ▼  \x1f
*/
  #if FUENTE_MAX>=0x5A
  0x00, 0x00, 0x00, 0x00, 0x00, // SP  \x20
  0x00, 0x00, 0x5F, 0x00, 0x00, // !  \x21
  0x00, 0x07, 0x00, 0x07, 0x00, // "  \x22
  0x14, 0x7F, 0x14, 0x7F, 0x14, // #  \x23
  0x24, 0x2A, 0x7F, 0x2A, 0x12, // $  \x24
  0x23, 0x13, 0x08, 0x64, 0x62, // %  \x25
  0x36, 0x49, 0x56, 0x20, 0x50, // &  \x26
  0x00, 0x08, 0x07, 0x03, 0x00, // '  \x27
  0x00, 0x1C, 0x22, 0x41, 0x00, // (  \x28
  0x00, 0x41, 0x22, 0x1C, 0x00, // )  \x29
  0x2A, 0x1C, 0x7F, 0x1C, 0x2A, // *  \x2a
  0x08, 0x08, 0x3E, 0x08, 0x08, // +  \x2b
  0x00, 0x80, 0x70, 0x30, 0x00, // ,  \x2c
  0x08, 0x08, 0x08, 0x08, 0x08, // -  \x2d
  0x00, 0x00, 0x60, 0x60, 0x00, // .  \x2e
  0x20, 0x10, 0x08, 0x04, 0x02, // /  \x2f
  0x3E, 0x51, 0x49, 0x45, 0x3E, // 0  \x30
  0x00, 0x42, 0x7F, 0x40, 0x00, // 1  \x31
  0x72, 0x49, 0x49, 0x49, 0x46, // 2  \x32
  0x21, 0x41, 0x49, 0x4D, 0x33, // 3  \x33
  0x18, 0x14, 0x12, 0x7F, 0x10, // 4  \x34
  0x27, 0x45, 0x45, 0x45, 0x39, // 5  \x35
  0x3C, 0x4A, 0x49, 0x49, 0x31, // 6  \x36
  0x41, 0x21, 0x11, 0x09, 0x07, // 7  \x37
  0x36, 0x49, 0x49, 0x49, 0x36, // 8  \x38
  0x46, 0x49, 0x49, 0x29, 0x1E, // 9  \x39
  0x00, 0x00, 0x14, 0x00, 0x00, // :  \x3a
  0x00, 0x40, 0x34, 0x00, 0x00, // ;  \x3b
  0x00, 0x08, 0x14, 0x22, 0x41, // <  \x3c
  0x14, 0x14, 0x14, 0x14, 0x14, // =  \x3d
  0x00, 0x41, 0x22, 0x14, 0x08, // >  \x3e
  0x02, 0x01, 0x59, 0x09, 0x06, // ?  \x3f
  0x3E, 0x41, 0x5D, 0x59, 0x4E, // @  \x40
  0x7C, 0x12, 0x11, 0x12, 0x7C, // A  \x41
  0x7F, 0x49, 0x49, 0x49, 0x36, // B  \x42
  0x3E, 0x41, 0x41, 0x41, 0x22, // C  \x43
  0x7F, 0x41, 0x41, 0x41, 0x3E, // D  \x44
  0x7F, 0x49, 0x49, 0x49, 0x41, // E  \x45
  0x7F, 0x09, 0x09, 0x09, 0x01, // F  \x46
  0x3E, 0x41, 0x41, 0x51, 0x73, // G  \x47
  0x7F, 0x08, 0x08, 0x08, 0x7F, // H  \x48
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
  #endif
  #if FUENTE_MAX>=0x5F
  0x00, 0x7F, 0x41, 0x41, 0x41, // [  \x5b
  0x02, 0x04, 0x08, 0x10, 0x20, // \  \x5c
  0x00, 0x41, 0x41, 0x41, 0x7F, // ]  \x5d
  0x04, 0x02, 0x01, 0x02, 0x04, // ^  \x5e
  0x40, 0x40, 0x40, 0x40, 0x40, // _  \x5f
  #endif
  #if FUENTE_MAX>=0x7F
  0x00, 0x03, 0x07, 0x08, 0x00, // `  \x60
  0x20, 0x54, 0x54, 0x78, 0x40, // a  \x61
  0x7F, 0x28, 0x44, 0x44, 0x38, // b  \x62
  0x38, 0x44, 0x44, 0x44, 0x28, // c  \x63
  0x38, 0x44, 0x44, 0x28, 0x7F, // d  \x64
  0x38, 0x54, 0x54, 0x54, 0x18, // e  \x65
  0x00, 0x08, 0x7E, 0x09, 0x02, // f  \x66
  0x18, 0xA4, 0xA4, 0x9C, 0x78, // g  \x67
  0x7F, 0x08, 0x04, 0x04, 0x78, // h  \x68
  0x00, 0x44, 0x7D, 0x40, 0x00, // i  \x69
  0x20, 0x40, 0x40, 0x3D, 0x00, // j  \x6a
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
  0x00, 0x00, 0x10, 0x10, 0x00, // ·  \xfa
  0x30, 0x40, 0xFF, 0x01, 0x01, // √  \xfb
  0x00, 0x1F, 0x01, 0x01, 0x1E, // ⁿ  \xfc
  0x00, 0x19, 0x1D, 0x17, 0x12, // ²  \xfd
  0x00, 0x3C, 0x3C, 0x3C, 0x3C, // ■  \xfe
  0x00, 0x00, 0x00, 0x00, 0x00, // NBSP  \xff
  #endif
};
//
